leshyazure/AQUAcontrol/PCB/mainboard/rev0/mainboard.kicad_pcb

## KiCad design PCB/mainboard/rev0/mainboard.kicad_pcb (2023-04-26)

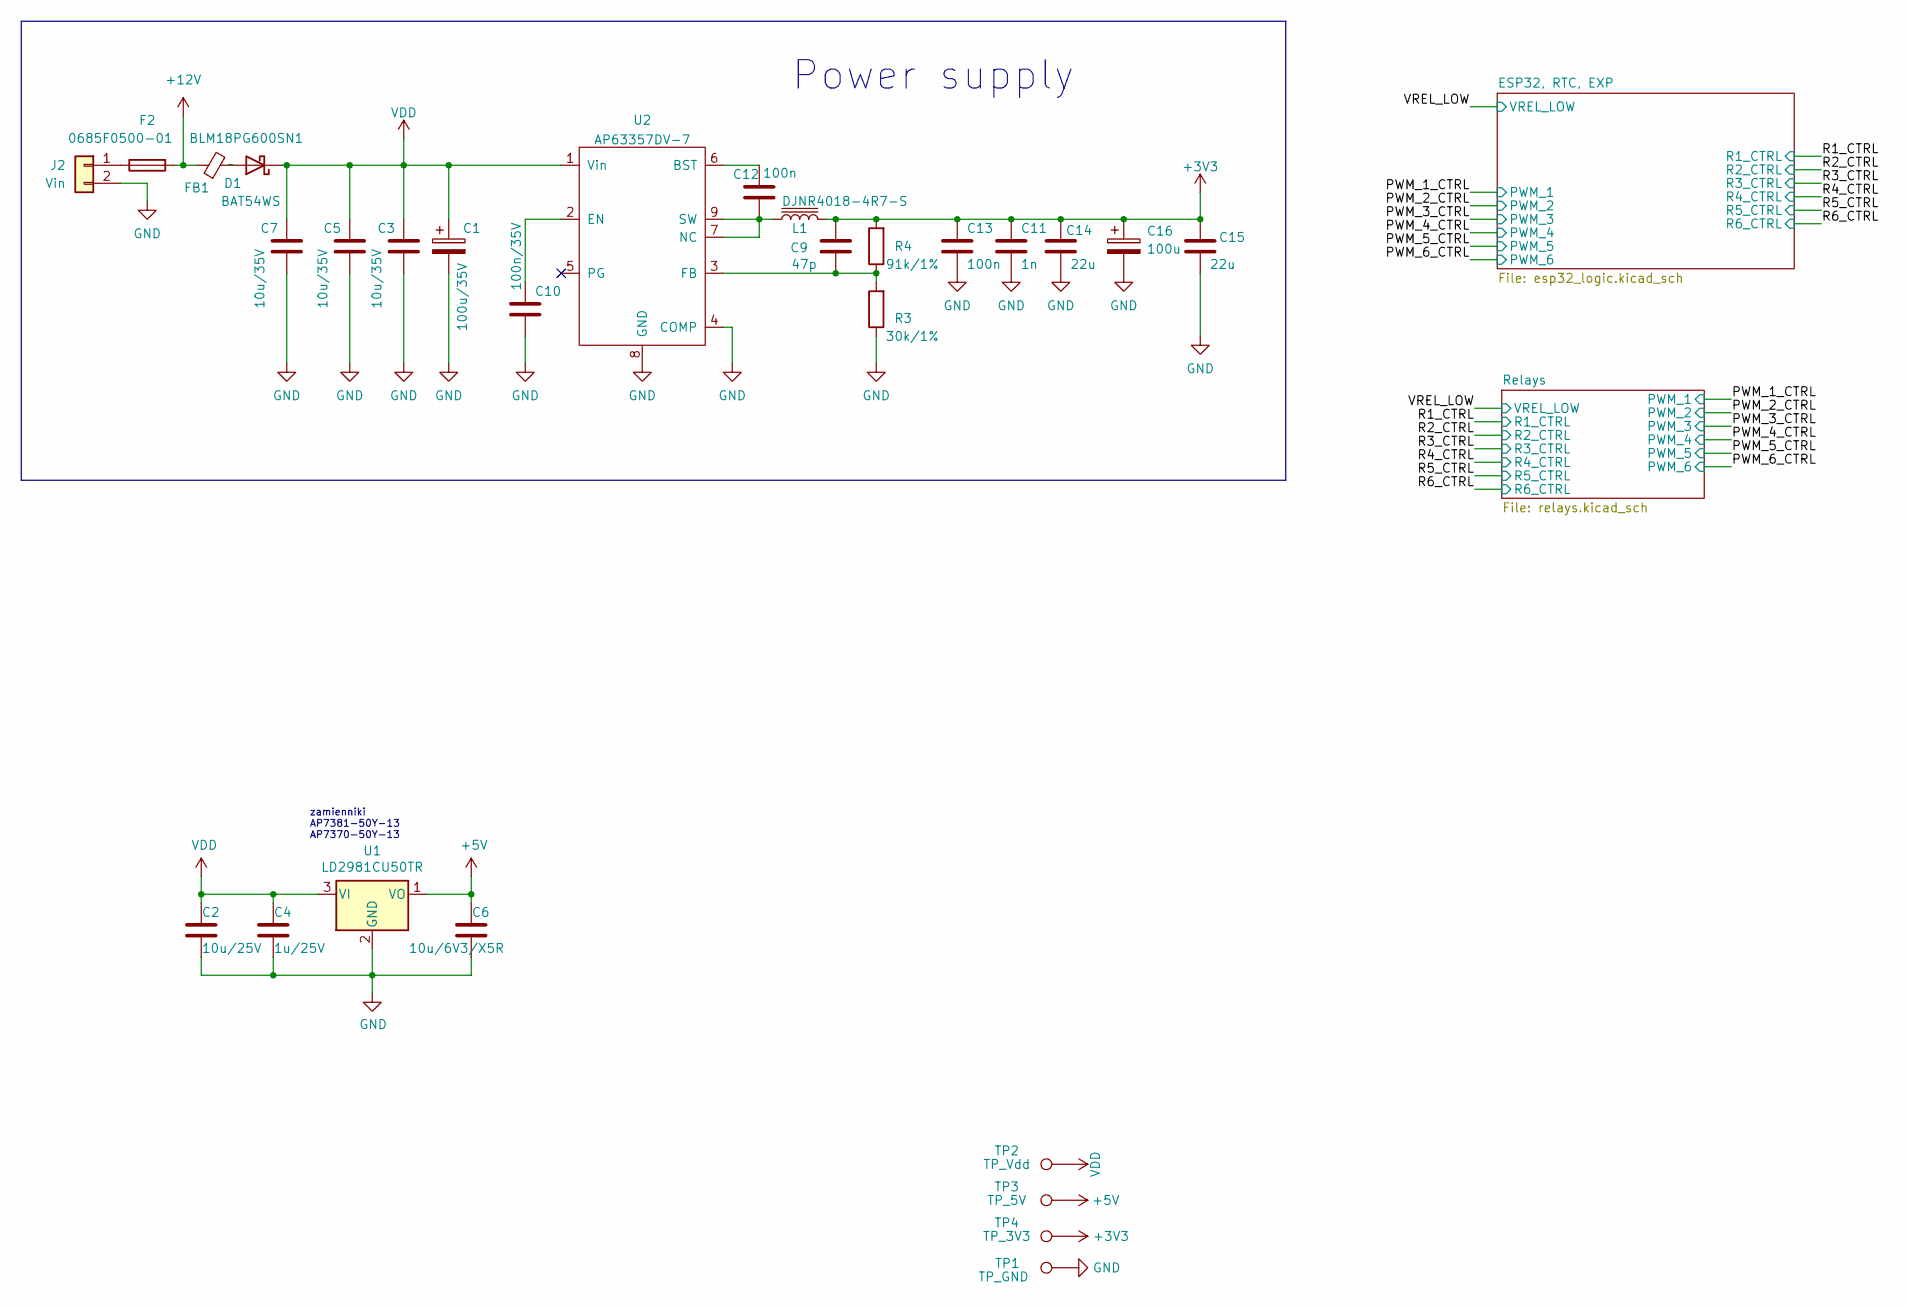
[picture p1: schematic mainboard.kicad_sch]

Parts:
C1: 100u/35V; CP_Elec_6.3x5.4
C2: 10u/25V; C_0805_2012Metric
C3, C5, C7: 10u/35V; C_1206_3216Metric
C4: 1u/25V; C_0603_1608Metric
C6: 10u/6V3/X5R; C_0603_1608Metric
C9: 47p; C_0603_1608Metric
C10: 100n/35V; C_0603_1608Metric
C11: 1n; C_0603_1608Metric
C12, C13: 100n; C_0603_1608Metric
C14, C15: 22u; C_0805_2012Metric
C16: 100u; CP_Elec_6.3x5.4
D1: BAT54WS; SOT-23
F2: 0685F0500-01; Fuse_1206_3216Metric
FB1: BLM18PG600SN1; L_0603_1608Metric
J2: Vin; PhoenixContact_MSTBA_2,5_2-G-5,08_1x02_P5.08mm_Horizontal
L1: DJNR4018-4R7-S; L_Bourns-SRN4018
R3: 30k/1%; R_0603_1608Metric_Pad0.98x0.95mm_HandSolder
R4: 91k/1%; R_0603_1608Metric_Pad0.98x0.95mm_HandSolder
TP1: TP_GND; TestPoint_THTPad_D1.0mm_Drill0.5mm
TP2: TP_Vdd; TestPoint_THTPad_D1.0mm_Drill0.5mm
TP3: TP_5V; TestPoint_THTPad_D1.0mm_Drill0.5mm
TP4: TP_3V3; TestPoint_THTPad_D1.0mm_Drill0.5mm
U1: LD2981CU50TR; SOT-89-3
U2: AP63357DV-7; V-DFN3020-13_Type_A_grid_stencil

Connections:
+3V3: C9.1, C11.1, C13.1, C14.1, C15.1, C16.1, L1.2, R4.2, TP4.1; also elsewhere on the board
+5V: C6.1, TP3.1, U1.1 (VO); also elsewhere on the board
+12V: F2.2, FB1.1; also elsewhere on the board
GND: C1.2, C2.2, C3.2, C4.2, C5.2, C6.2, C7.2, C10.2, C11.2, C13.2, C14.2, C15.2, C16.2, J2.2, R3.1, TP1.1, U1.2 (GND), U2.4 (COMP), U2.8 (GND); also elsewhere on the board
unnamed: C9.2, R3.2, R4.1, U2.3 (FB)
unnamed: C10.1, U2.2 (EN)
unnamed: C12.1, U2.6 (BST)
unnamed: C12.2, L1.1, U2.7 (NC), U2.9 (SW)
unnamed: D1.2 (A), FB1.2
unnamed: F2.1, J2.1
VDD: C1.1, C2.1, C3.1, C4.1, C5.1, C7.1, D1.1 (K), TP2.1, U1.3 (VI), U2.1 (Vin); also elsewhere on the board

Notes on the sheet:
zamienniki AP7381-50Y-13 AP7370-50Y-13
Power supply

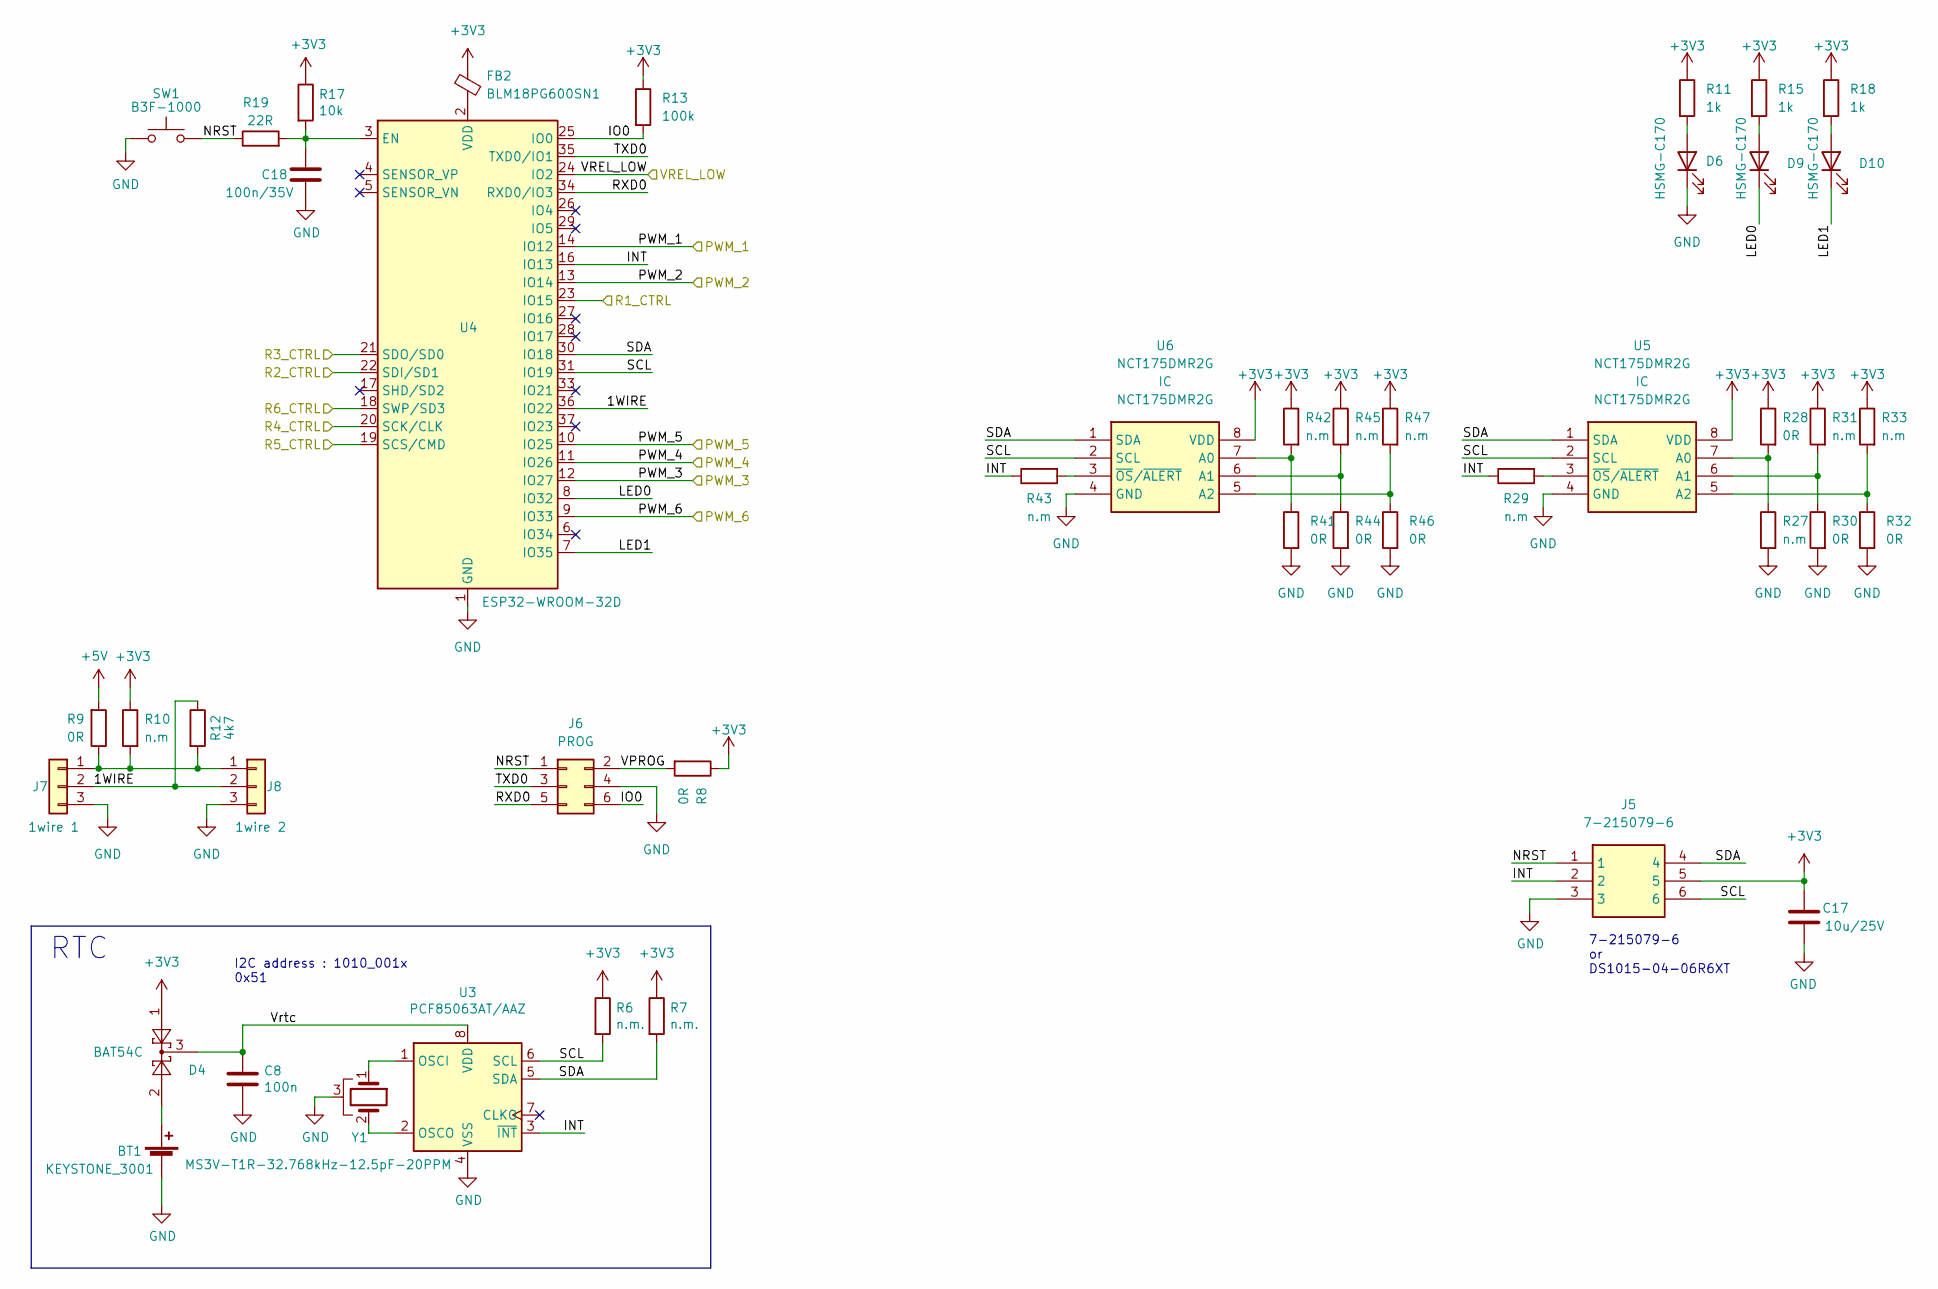
[picture p2: schematic esp32_logic.kicad_sch]

Parts:
BT1: KEYSTONE_3001; BatteryHolder_Keystone_3001_1x12mm
C8: 100n; C_0603_1608Metric_Pad1.08x0.95mm_HandSolder
C17: 10u/25V; C_1206_3216Metric_Pad1.33x1.80mm_HandSolder
C18: 100n/35V; C_0603_1608Metric_Pad1.08x0.95mm_HandSolder
D4: BAT54C; SOT-23
D6, D9, D10: HSMG-C170; LED_0805_2012Metric_Pad1.15x1.40mm_HandSolder
FB2: BLM18PG600SN1; L_0603_1608Metric
J5: 7-215079-6; Mouser Part Number 571-72150796
J6: PROG; PinHeader_2x03_P1.27mm_Vertical
J7: 1wire 1; JST_PH_B3B-PH-K_1x03_P2.00mm_Vertical
J8: 1wire 2; JST_PH_B3B-PH-K_1x03_P2.00mm_Vertical
R6, R7: n.m.; R_0603_1608Metric_Pad0.98x0.95mm_HandSolder
R8, R9: 0R; R_0603_1608Metric_Pad0.98x0.95mm_HandSolder
R10: n.m; R_0603_1608Metric_Pad0.98x0.95mm_HandSolder
R11, R15, R18: 1k; R_0603_1608Metric_Pad0.98x0.95mm_HandSolder
R12: 4k7; R_0603_1608Metric_Pad0.98x0.95mm_HandSolder
R13: 100k; R_0603_1608Metric_Pad0.98x0.95mm_HandSolder
R17: 10k; R_0603_1608Metric_Pad0.98x0.95mm_HandSolder
R19: 22R; R_0603_1608Metric_Pad0.98x0.95mm_HandSolder
R27, R29, R31, R33, R42, R43, R45, R47: n.m; R_0402_1005Metric_Pad0.72x0.64mm_HandSolder
R28, R30, R32, R41, R44, R46: 0R; R_0402_1005Metric_Pad0.72x0.64mm_HandSolder
SW1: B3F-1000; PTS815SJM250SMTRLFS
U3: PCF85063AT/AAZ; SOIC-8_3.9x4.9mm_P1.27mm
U4: ESP32-WROOM-32D; ESP32-WROOM-32
U5, U6: NCT175DMR2G; SOP65P490X110-8N; Mouser Part Number 863-NCT175DMR2G
Y1: MS3V-T1R-32.768kHz-12.5pF-20PPM; Crystal_SMD_MicroCrystal_MS3V-T1R

Connections:
+3V3: C17.1, D4.1, FB2.2, J5.5, R6.1, R7.1, R8.1, R10.1, R11.1, R13.1, R15.1, R17.1, R18.1, R28.1, R31.1, R33.1, R42.1, R45.1, R47.1, U5.8 (VDD), U6.8 (VDD); also elsewhere on the board
+5V: R9.2; also elsewhere on the board
/ESP32, RTC, EXP/1WIRE: J7.2, J8.2, R12.1, U4.36 (IO22)
/ESP32, RTC, EXP/INT: J5.2, R29.1, R43.1, U3.3 (~INT), U4.16 (IO13)
/ESP32, RTC, EXP/IO0: J6.6, R13.2, U4.25 (IO0)
/ESP32, RTC, EXP/LED0: D9.1 (K), U4.8 (IO32)
/ESP32, RTC, EXP/LED1: D10.1 (K), U4.7 (IO35)
/ESP32, RTC, EXP/NRST: J5.1, J6.1, R19.1, SW1.3 (B), SW1.4 (B)
/ESP32, RTC, EXP/RXD0: J6.5, U4.34 (RXD0/IO3)
/ESP32, RTC, EXP/SCL: J5.6, R6.2, U3.6 (SCL), U4.31 (IO19), U5.2 (SCL), U6.2 (SCL)
/ESP32, RTC, EXP/SDA: J5.4, R7.2, U3.5 (SDA), U4.30 (IO18), U5.1 (SDA), U6.1 (SDA)
/ESP32, RTC, EXP/TXD0: J6.3, U4.35 (TXD0/IO1)
/ESP32, RTC, EXP/VPROG: J6.2, R8.2
/ESP32, RTC, EXP/Vrtc: C8.1, D4.3, U3.8 (VDD)
/PWM_1_CTRL: U4.14 (IO12); also elsewhere on the board
/PWM_2_CTRL: U4.13 (IO14); also elsewhere on the board
/PWM_3_CTRL: U4.12 (IO27); also elsewhere on the board
/PWM_4_CTRL: U4.11 (IO26); also elsewhere on the board
/PWM_5_CTRL: U4.10 (IO25); also elsewhere on the board
/PWM_6_CTRL: U4.9 (IO33); also elsewhere on the board
/R1_CTRL: U4.23 (IO15); also elsewhere on the board
/R2_CTRL: U4.22 (SDI/SD1); also elsewhere on the board
/R3_CTRL: U4.21 (SDO/SD0); also elsewhere on the board
/R4_CTRL: U4.20 (SCK/CLK); also elsewhere on the board
/R5_CTRL: U4.19 (SCS/CMD); also elsewhere on the board
/R6_CTRL: U4.18 (SWP/SD3); also elsewhere on the board
/VREL_LOW: U4.24 (IO2); also elsewhere on the board
GND: BT1.2 (-), C8.2, C17.2, C18.2, D6.1 (K), J5.3, J6.4, J7.3, J8.3, R27.2, R30.2, R32.2, R41.2, R44.2, R46.2, SW1.1 (A), SW1.2 (A), U3.4 (VSS), U4.1 (GND), U4.15 (GND), U4.38 (GND), U4.39 (GND), U5.4 (GND), U6.4 (GND), Y1.3; also elsewhere on the board
unnamed: BT1.1 (+), D4.2
unnamed: C18.1, R17.2, R19.2, U4.3 (EN)
unnamed: D6.2 (A), R11.2
unnamed: D9.2 (A), R15.2
unnamed: D10.2 (A), R18.2
unnamed: FB2.1, U4.2 (VDD)
unnamed: J7.1, J8.1, R9.1, R10.2, R12.2
unnamed: R27.1, R28.2, U5.7 (A0)
unnamed: R29.2, U5.3 (~OS/~ALERT)
unnamed: R30.1, R31.2, U5.6 (A1)
unnamed: R32.1, R33.2, U5.5 (A2)
unnamed: R41.1, R42.2, U6.7 (A0)
unnamed: R43.2, U6.3 (~OS/~ALERT)
unnamed: R44.1, R45.2, U6.6 (A1)
unnamed: R46.1, R47.2, U6.5 (A2)
unnamed: U3.1 (OSCI), Y1.1
unnamed: U3.2 (OSCO), Y1.2

Notes on the sheet:
RTC
I2C address : 1010_001x 0x51
7-215079-6 or DS1015-04-06R6XT

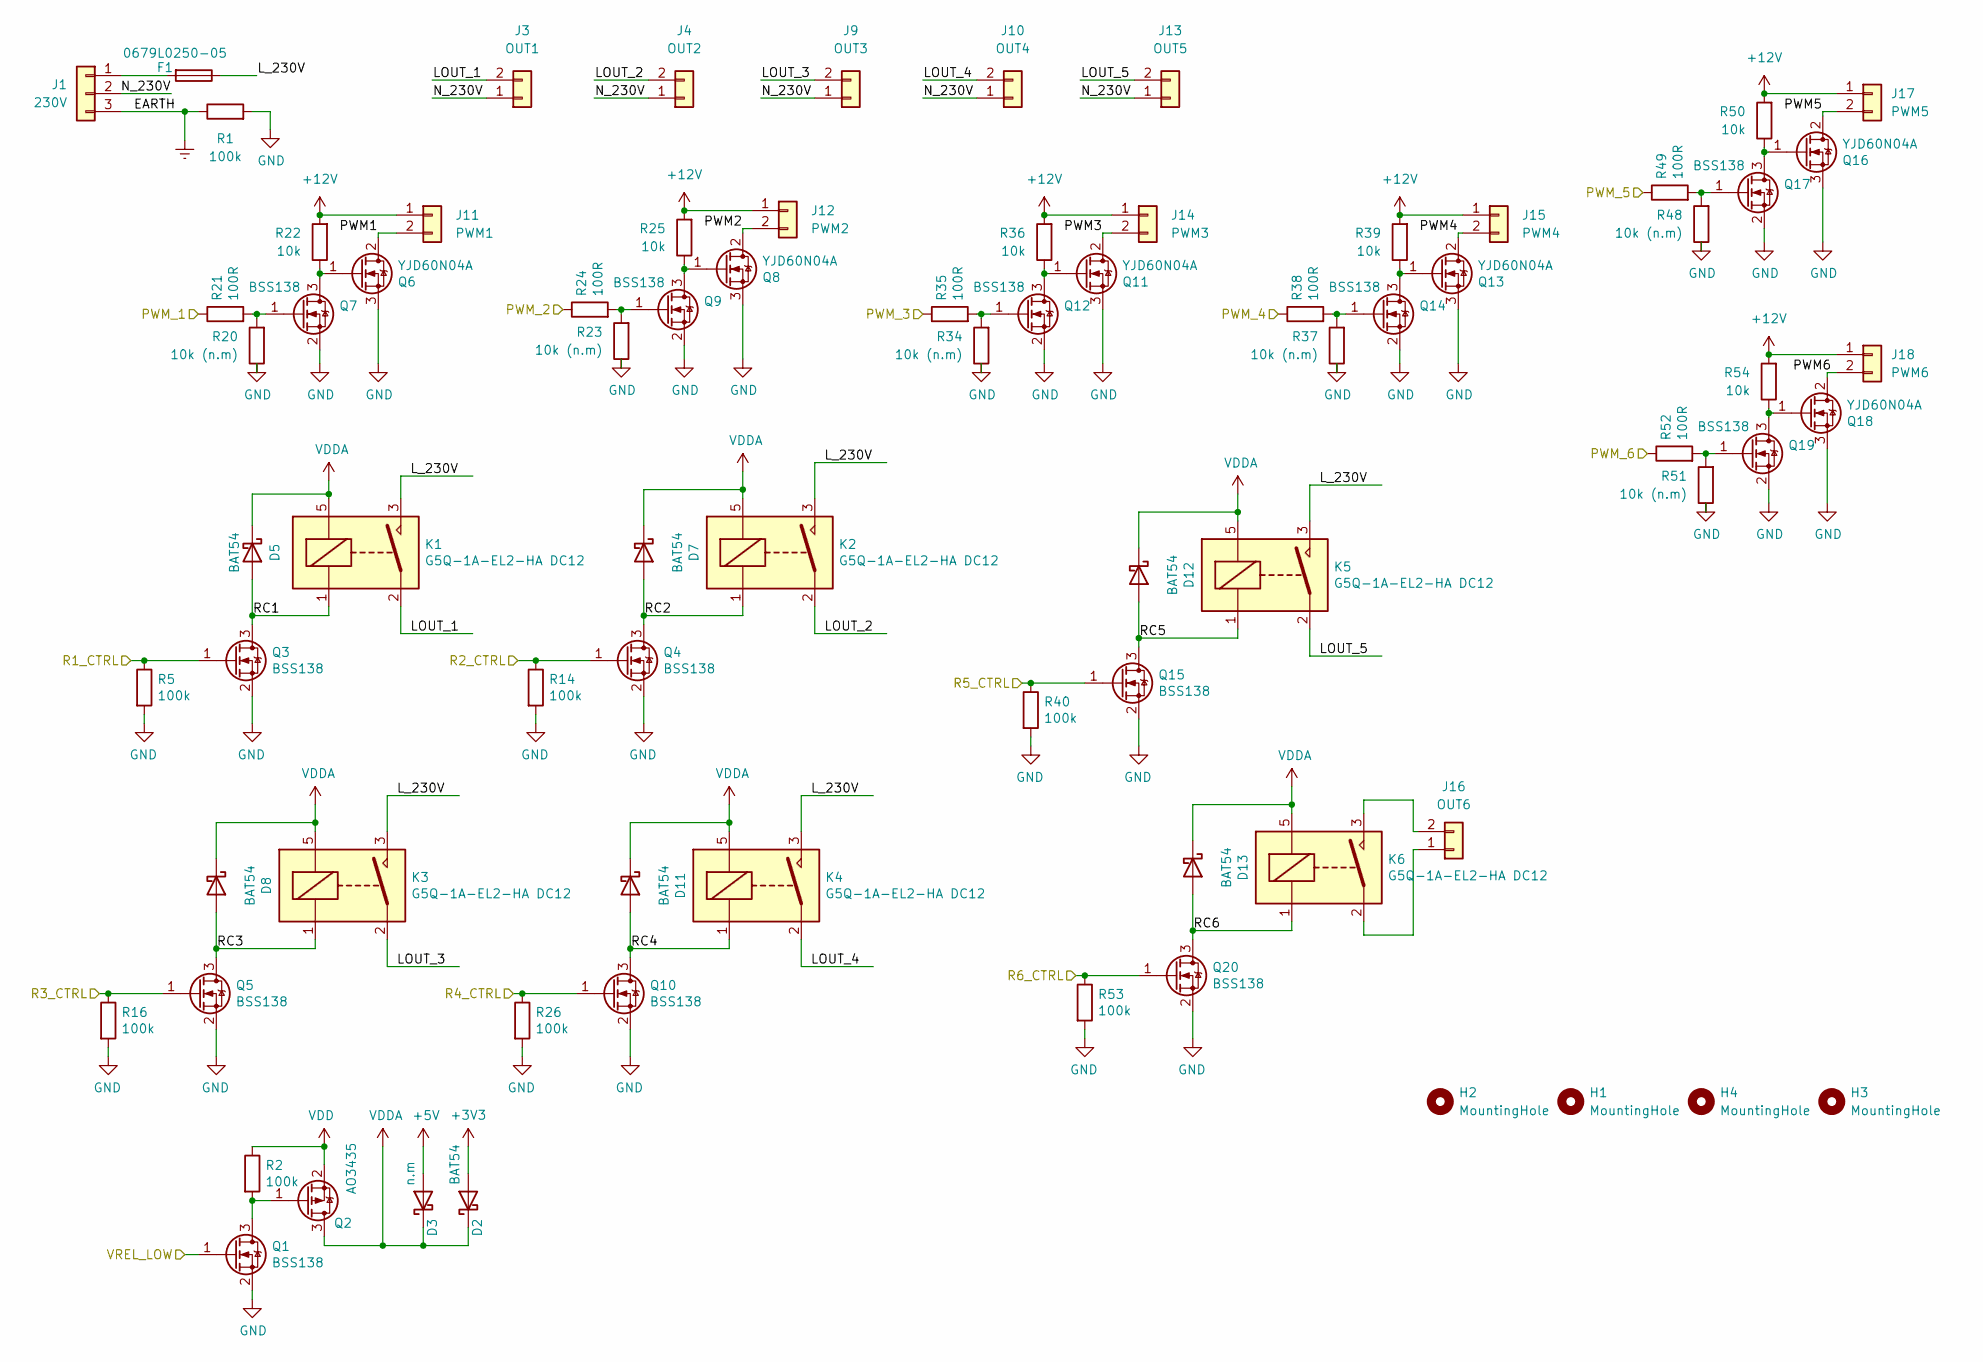
[picture p3: schematic relays.kicad_sch]

Parts:
D2, D5, D7, D8, D11, D12, D13: BAT54; SOT-23
D3: n.m; SOT-23
F1: 0679L0250-05; FUSC6125X279N
H1, H2, H3, H4: MountingHole; MountingHole_3.2mm_M3_Pad
J1: 230V; PhoenixContact_MSTBA_2,5_3-G-5,08_1x03_P5.08mm_Horizontal
J3: OUT1; PhoenixContact_MCV_1,5_2-G-3.5_1x02_P3.50mm_Vertical
J4: OUT2; PhoenixContact_MCV_1,5_2-G-3.5_1x02_P3.50mm_Vertical
J9: OUT3; PhoenixContact_MCV_1,5_2-G-3.5_1x02_P3.50mm_Vertical
J10: OUT4; PhoenixContact_MCV_1,5_2-G-3.5_1x02_P3.50mm_Vertical
J11: PWM1; JST_XH_B2B-XH-A_1x02_P2.50mm_Vertical
J12: PWM2; JST_XH_B2B-XH-A_1x02_P2.50mm_Vertical
J13: OUT5; PhoenixContact_MCV_1,5_2-G-3.5_1x02_P3.50mm_Vertical
J14: PWM3; JST_XH_B2B-XH-A_1x02_P2.50mm_Vertical
J15: PWM4; JST_XH_B2B-XH-A_1x02_P2.50mm_Vertical
J16: OUT6; PhoenixContact_MCV_1,5_2-G-3.5_1x02_P3.50mm_Vertical
J17: PWM5; JST_XH_B2B-XH-A_1x02_P2.50mm_Vertical
J18: PWM6; JST_XH_B2B-XH-A_1x02_P2.50mm_Vertical
K1, K2, K3, K4, K5, K6: G5Q-1A-EL2-HA DC12; Relay_SPST_Omron-G5Q-1A-sst_pf
Q1, Q3, Q4, Q5, Q7, Q9, Q10, Q12, Q14, Q15, Q17, Q19, Q20: BSS138; SOT-23
Q2: AO3435; SOT-23
Q6, Q8, Q11, Q13, Q16, Q18: YJD60N04A; TO-252-2
R1, R2, R5, R14, R16, R26, R40, R53: 100k; R_0603_1608Metric_Pad0.98x0.95mm_HandSolder
R20, R23, R34, R37, R48, R51: 10k (n.m); R_0603_1608Metric_Pad0.98x0.95mm_HandSolder
R21, R24, R35, R38, R49, R52: 100R; R_0603_1608Metric_Pad0.98x0.95mm_HandSolder
R22, R25, R36, R39, R50, R54: 10k; R_0603_1608Metric_Pad0.98x0.95mm_HandSolder

Connections:
+3V3: D2.1 (A); also elsewhere on the board
+5V: D3.1 (A); also elsewhere on the board
+12V: J11.1, J12.1, J14.1, J15.1, J17.1, J18.1, R22.2, R25.2, R36.2, R39.2, R50.2, R54.2; also elsewhere on the board
/PWM_1_CTRL: R21.1; also elsewhere on the board
/PWM_2_CTRL: R24.1; also elsewhere on the board
/PWM_3_CTRL: R35.1; also elsewhere on the board
/PWM_4_CTRL: R38.1; also elsewhere on the board
/PWM_5_CTRL: R49.1; also elsewhere on the board
/PWM_6_CTRL: R52.1; also elsewhere on the board
/R1_CTRL: Q3.1 (G), R5.1; also elsewhere on the board
/R2_CTRL: Q4.1 (G), R14.1; also elsewhere on the board
/R3_CTRL: Q5.1 (G), R16.1; also elsewhere on the board
/R4_CTRL: Q10.1 (G), R26.1; also elsewhere on the board
/R5_CTRL: Q15.1 (G), R40.1; also elsewhere on the board
/R6_CTRL: Q20.1 (G), R53.1; also elsewhere on the board
/Relays/LOUT_1: J3.2, K1.2
/Relays/LOUT_2: J4.2, K2.2
/Relays/LOUT_3: J9.2, K3.2
/Relays/LOUT_4: J10.2, K4.2
/Relays/LOUT_5: J13.2, K5.2
/Relays/L_230V: F1.1, K1.3, K2.3, K3.3, K4.3, K5.3
/Relays/N_230V: J1.2, J3.1, J4.1, J9.1, J10.1, J13.1
/Relays/PWM1: J11.2, Q6.2 (D)
/Relays/PWM2: J12.2, Q8.2 (D)
/Relays/PWM3: J14.2, Q11.2 (D)
/Relays/PWM4: J15.2, Q13.2 (D)
/Relays/PWM5: J17.2, Q16.2 (D)
/Relays/PWM6: J18.2, Q18.2 (D)
/Relays/RC1: D5.1 (A), K1.1, Q3.3 (D)
/Relays/RC2: D7.1 (A), K2.1, Q4.3 (D)
/Relays/RC3: D8.1 (A), K3.1, Q5.3 (D)
/Relays/RC4: D11.1 (A), K4.1, Q10.3 (D)
/Relays/RC5: D12.1 (A), K5.1, Q15.3 (D)
/Relays/RC6: D13.1 (A), K6.1, Q20.3 (D)
/VREL_LOW: Q1.1 (G); also elsewhere on the board
Earth: J1.3, R1.1
GND: Q1.2 (S), Q3.2 (S), Q4.2 (S), Q5.2 (S), Q6.3 (S), Q7.2 (S), Q8.3 (S), Q9.2 (S), Q10.2 (S), Q11.3 (S), Q12.2 (S), Q13.3 (S), Q14.2 (S), Q15.2 (S), Q16.3 (S), Q17.2 (S), Q18.3 (S), Q19.2 (S), Q20.2 (S), R1.2, R5.2, R14.2, R16.2, R20.1, R23.1, R26.2, R34.1, R37.1, R40.2, R48.1, R51.1, R53.2; also elsewhere on the board
unnamed: F1.2, J1.1
unnamed: J16.1, K6.2
unnamed: J16.2, K6.3
unnamed: Q1.3 (D), Q2.1 (G), R2.2
unnamed: Q6.1 (G), Q7.3 (D), R22.1
unnamed: Q7.1 (G), R20.2, R21.2
unnamed: Q8.1 (G), Q9.3 (D), R25.1
unnamed: Q9.1 (G), R23.2, R24.2
unnamed: Q11.1 (G), Q12.3 (D), R36.1
unnamed: Q12.1 (G), R34.2, R35.2
unnamed: Q13.1 (G), Q14.3 (D), R39.1
unnamed: Q14.1 (G), R37.2, R38.2
unnamed: Q16.1 (G), Q17.3 (D), R50.1
unnamed: Q17.1 (G), R48.2, R49.2
unnamed: Q18.1 (G), Q19.3 (D), R54.1
unnamed: Q19.1 (G), R51.2, R52.2
VDD: Q2.2 (S), R2.1; also elsewhere on the board
VDDA: D2.3 (K), D3.3 (K), D5.3 (K), D7.3 (K), D8.3 (K), D11.3 (K), D12.3 (K), D13.3 (K), K1.5, K2.5, K3.5, K4.5, K5.5, K6.5, Q2.3 (D)

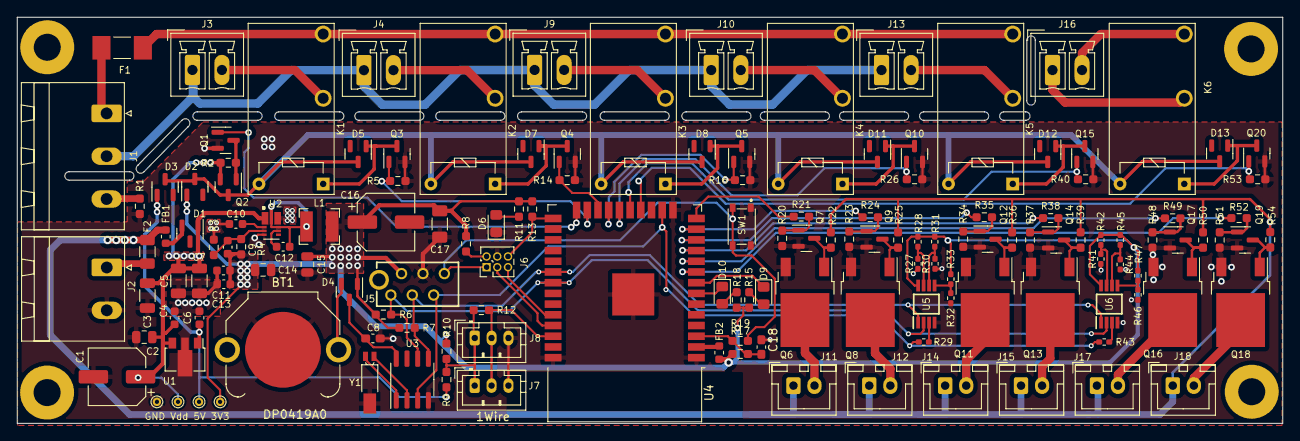
[picture p4: board mainboard.kicad_pcb from above]

Board: 2 copper layers, 150.1 x 48.2 mm, 151 parts (0 on the bottom side), 90 nets.
